rykovv/folding-flash-adc-pspice/adc_flash_4b_interp_fold/ADC_FLASH_4B_INTERP_FOLD.png

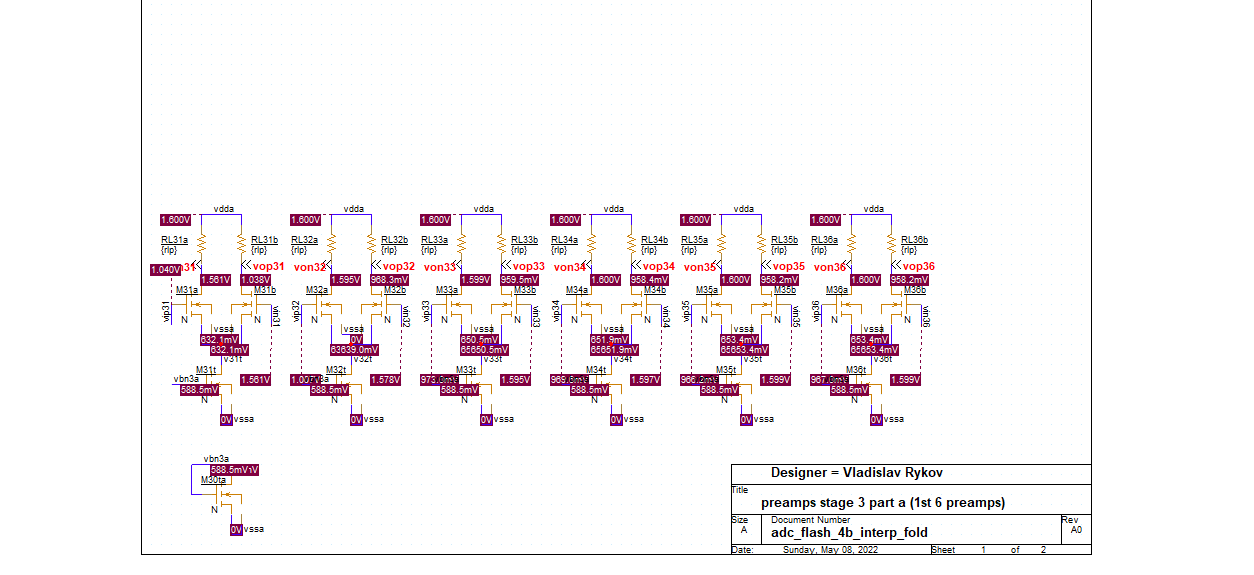
adc_flash_4b_interp_fold/ADC_FLASH_4B_INTERP_FOLD.png
