rykovv/folding-flash-adc-pspice/adc_flash_4b_interp_fold/adc_flash_4b_interp_fold.pdf

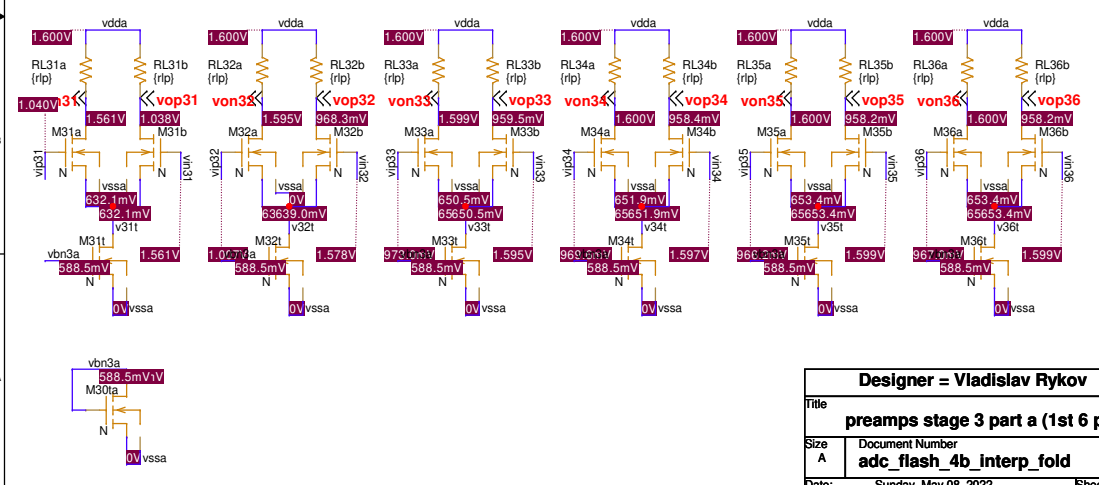
[picture p3: page 1]
von31; vop31 von32; vop32 von33; vop33 von34; vop34 von35; vop35 von36; vop36; Size; Document Number; Rev; Date:; Sheet; adc_flash_4b_interp_fold; 2Sunday, May 08, 2022; RL35a {rlp}; RL35b {rlp}; RL33a {rlp}; RL31b {rlp}; RL36a {rlp}; RL34a {rlp}; RL33b {rlp}; RL32a {rlp}; RL31a {rlp}; RL34b {rlp}; RL32b {rlp}; RL36b {rlp}; vdda; vssa 632.1mV 0V 632.1mV v31t; vip31; vin31; vssa 0V 63639 9.0mV.0mV; vssa 650.5mV 0V 650.5mV; vssa 651.9mV 0V 651.9mV; vssa 653.4mV 0V 653.4mV; vip32; vin32; vip33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

Designer = Vladislav Rykov

Title
preamps stage 3 part a (1st 6 preamps)

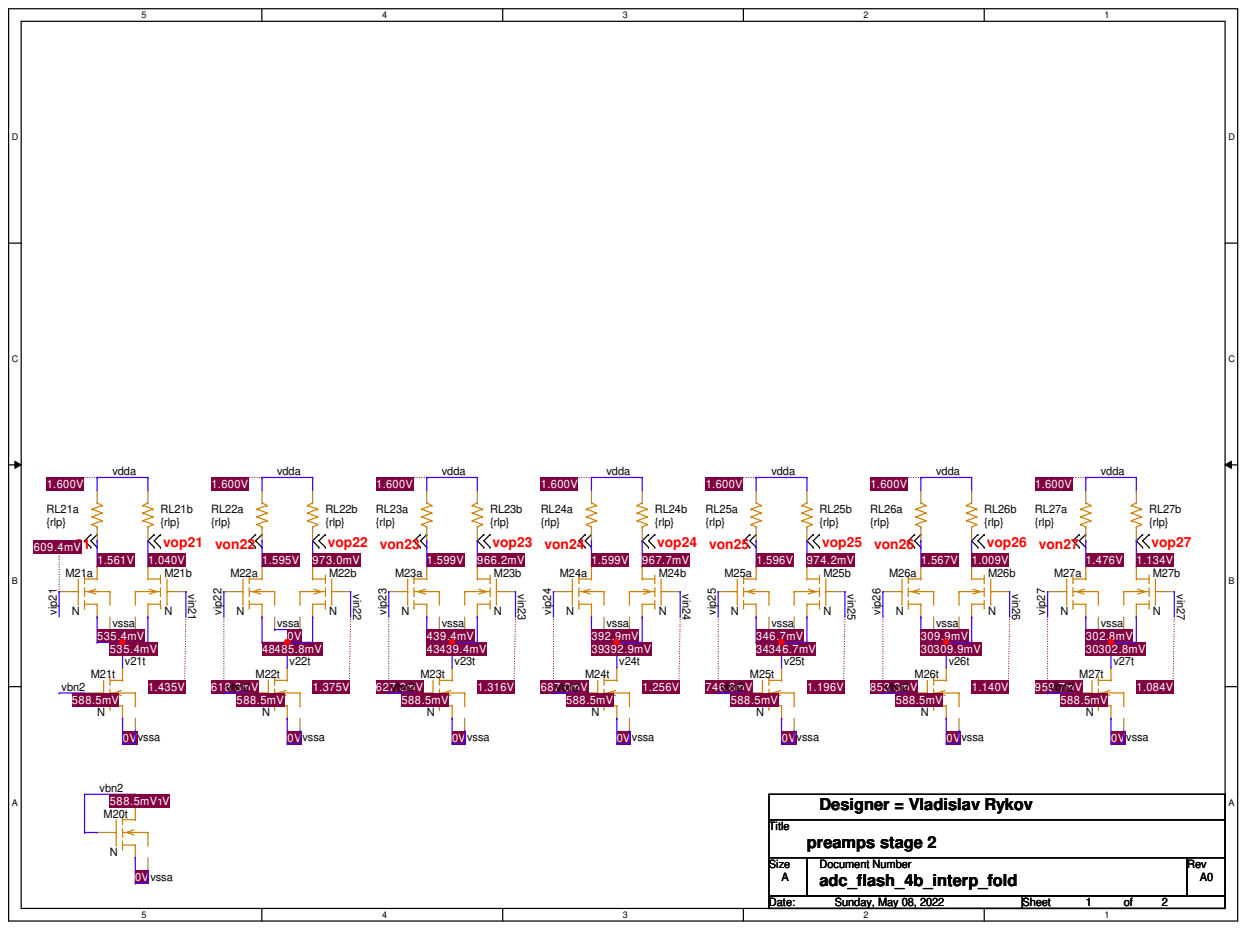
[picture p4: page 2]
von21; vop21 von22; vop22 von23; vop23 von24; vop24 von25; vop25 von26; vop26 von27; vop27; Title; Size; Document Number; Rev; adc_flash_4b_interp_fold; preamps stage 2; RL27b {rlp}; RL24a {rlp}; RL23b {rlp}; RL26a {rlp}; RL25b {rlp}; RL22a {rlp}; RL25a {rlp}; RL27a {rlp}; RL26b {rlp}; RL21a {rlp}; RL23a {rlp}; RL24b {rlp}; RL21b {rlp}; RL22b {rlp}; vdda; vssa 535.4mV 0V 535.4mV v21t; vip21; vin21; vssa 0V 48485 5.8mV.8mV; vssa 439.4mV 0V 439.4mV; vssa 392.9mV 0V 392.9mV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

Designer = Vladislav Rykov

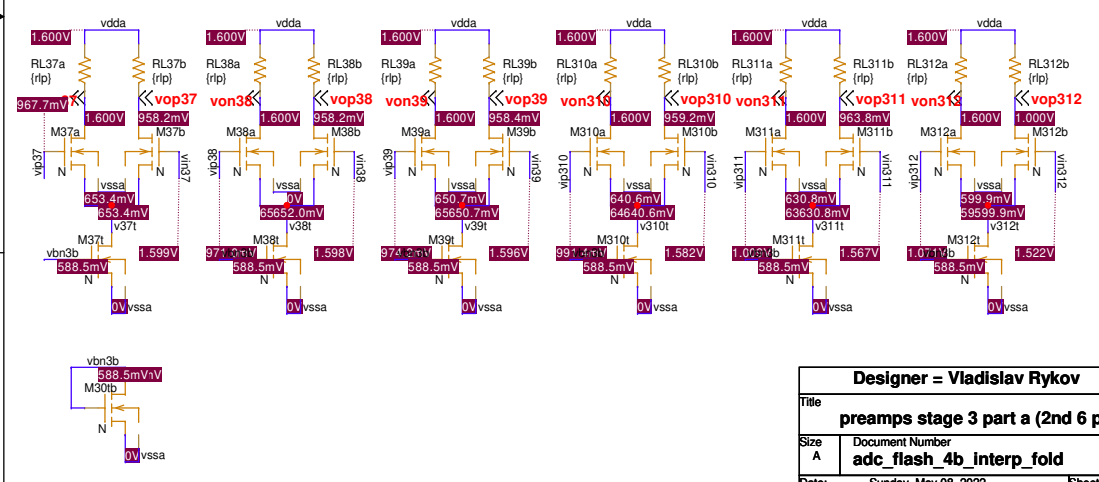
[picture p5: page 3]
von37; vop37 von38; vop38 von39; vop39 von310; vop310 von311; vop311 von312; vop312; Size; Document Number; Rev; adc_flash_4b_interp_fold; RL38a {rlp}; RL38b {rlp}; RL312b {rlp}; RL39b {rlp}; RL37a {rlp}; RL311b {rlp}; RL310a {rlp}; RL310b {rlp}; RL37b {rlp}; RL311a {rlp}; RL39a {rlp}; RL312a {rlp}; vdda; vssa 653.4mV 0V 653.4mV v37t; vip37; vin37; vssa 0V 65652 2.0mV.0mV; vssa 650.7mV 0V 650.7mV; vssa 640.6mV 0V 640.6mV; vssa 630.8mV 0V 630.8mV; vip38; vin38; vip39; vin39; vip310; vin310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

Designer = Vladislav Rykov

Title
preamps stage 3 part a (2nd 6 preamps)

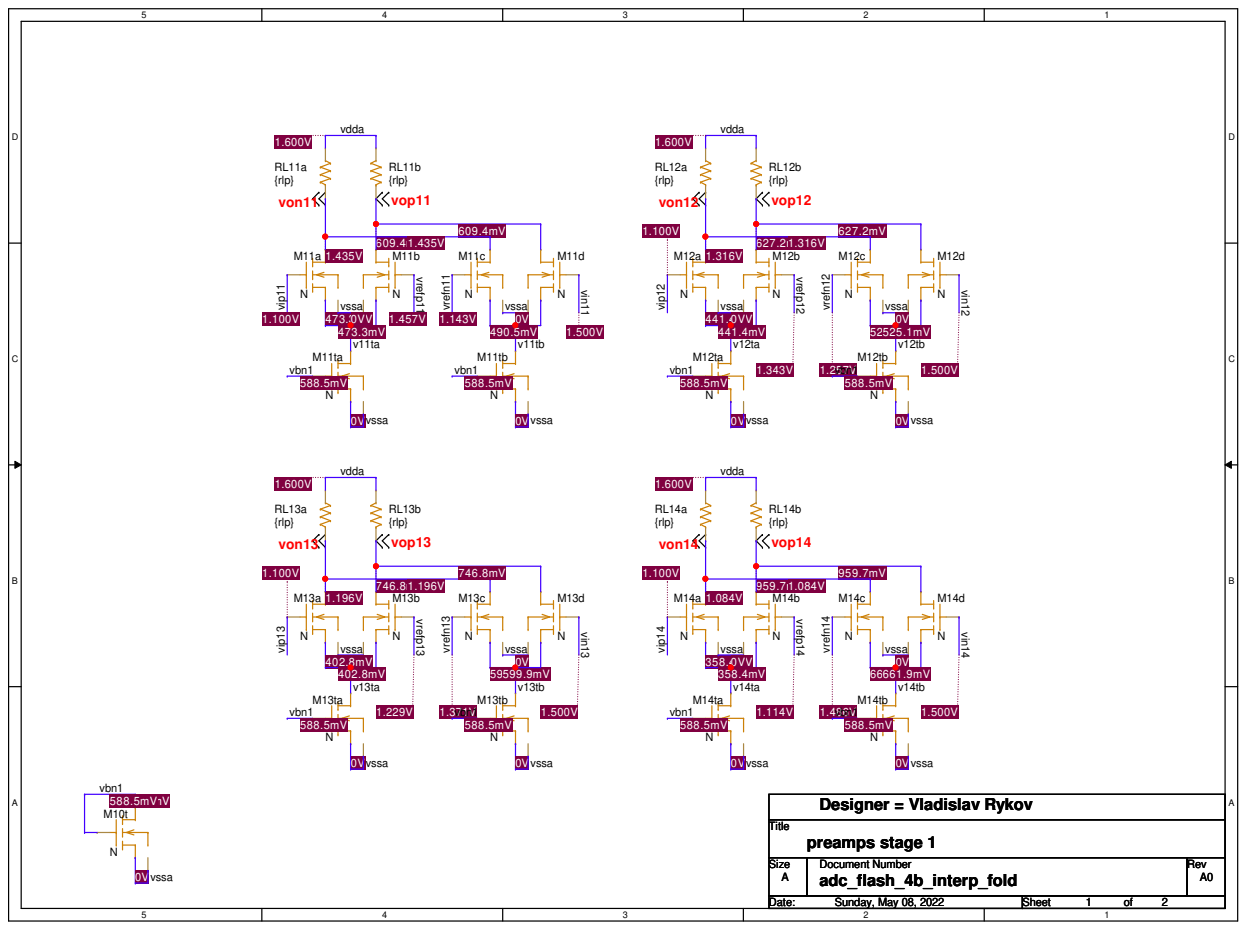
[picture p6: page 4]
von13; vop13; von11; vop11; von12; vop12; von14; vop14; Title; Size; Document Number; Rev; adc_flash_4b_interp_fold; preamps stage 1; RL11a {rlp}; RL13a {rlp}; RL11b {rlp}; RL12a {rlp}; RL12b {rlp}; RL14a {rlp}; RL13b {rlp}; RL14b {rlp}; vdda; vssa 402.8mV 0V 402.8mV v13ta; vip13; vrefp13; vssa 0V 599599.9mV.9mV; vrefn13; vin13; 0Vvssa; vbn1 588.5mV; vip11; vrefp11; vrefn11; vin11; vssa 0V; vip12; vrefp12; vrefn12; vin12; vip14; vrefp14; vrefn14; vin14

Designer = Vladislav Rykov

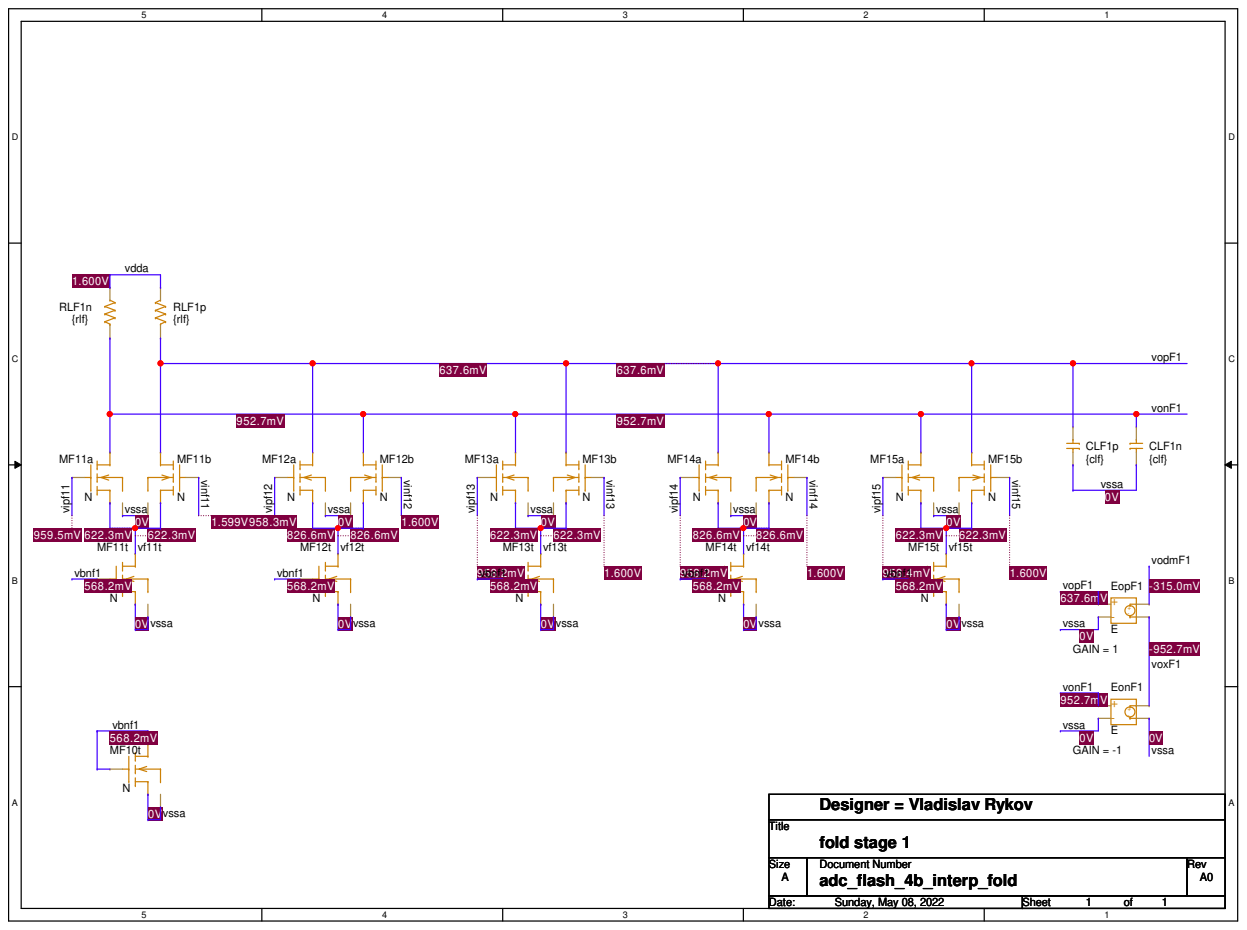
[picture p7: page 5]
Title; Size; Document Number; Rev; adc_flash_4b_interp_fold; fold stage 1; 1Sunday, May 08, 2022; CLF1n; {clf}; RLF1n {rlf}; -+ +-EopF1; GAIN = 1; RLF1p {rlf}; -+ +-EonF1; GAIN = -1; CLF1p; vdda; vopF1; vonF1; vipf11; vinf11; vipf12; vinf12; vipf13; vinf13; vipf14; vinf14; vipf15; vinf15; vssa 0V; vodmF1; voxF1 -952.7mV; vonF1 952.7mV; vssa; vbnf1 568.2mV; 0Vvssa

Designer = Vladislav Rykov

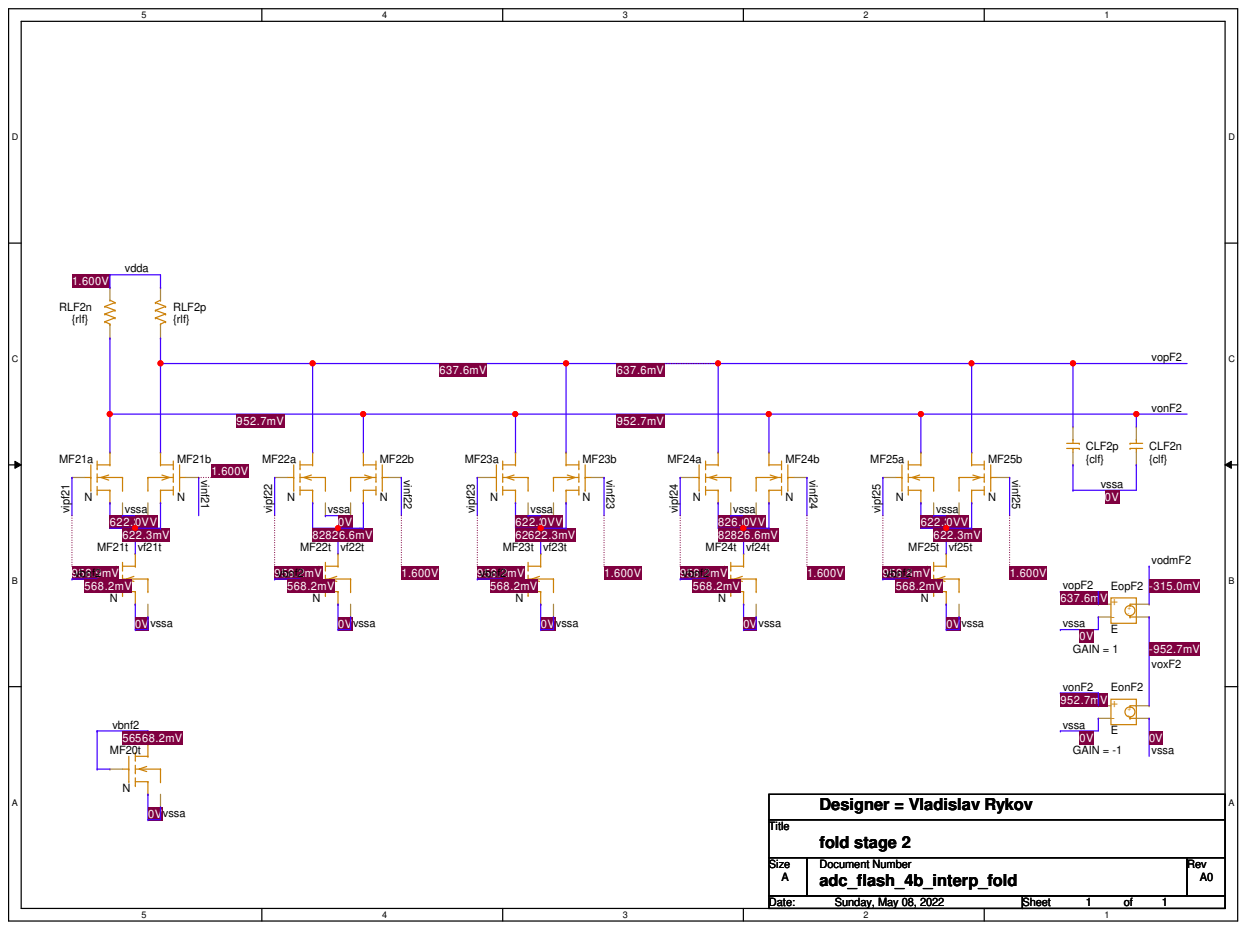
[picture p8: page 6]
Title; Size; Document Number; Rev; adc_flash_4b_interp_fold; fold stage 2; CLF2p {clf}; RLF2p {rlf}; RLF2n {rlf}; CLF2n {clf} -+ +-EonF2; GAIN = -1; -+ +-EopF2; GAIN = 1; vdda; vopF2; vonF2; vipf21; vinf21; vipf22; vinf22; vipf23; vinf23; vipf24; vinf24; vipf25; vinf25; vssa 0V; vodmF2; voxF2 -952.7mV; vonF2 952.7mV; vssa; vbnf2 568.2mV; 0Vvssa; vbnf2 56856.2mV 8.2mV

Designer = Vladislav Rykov

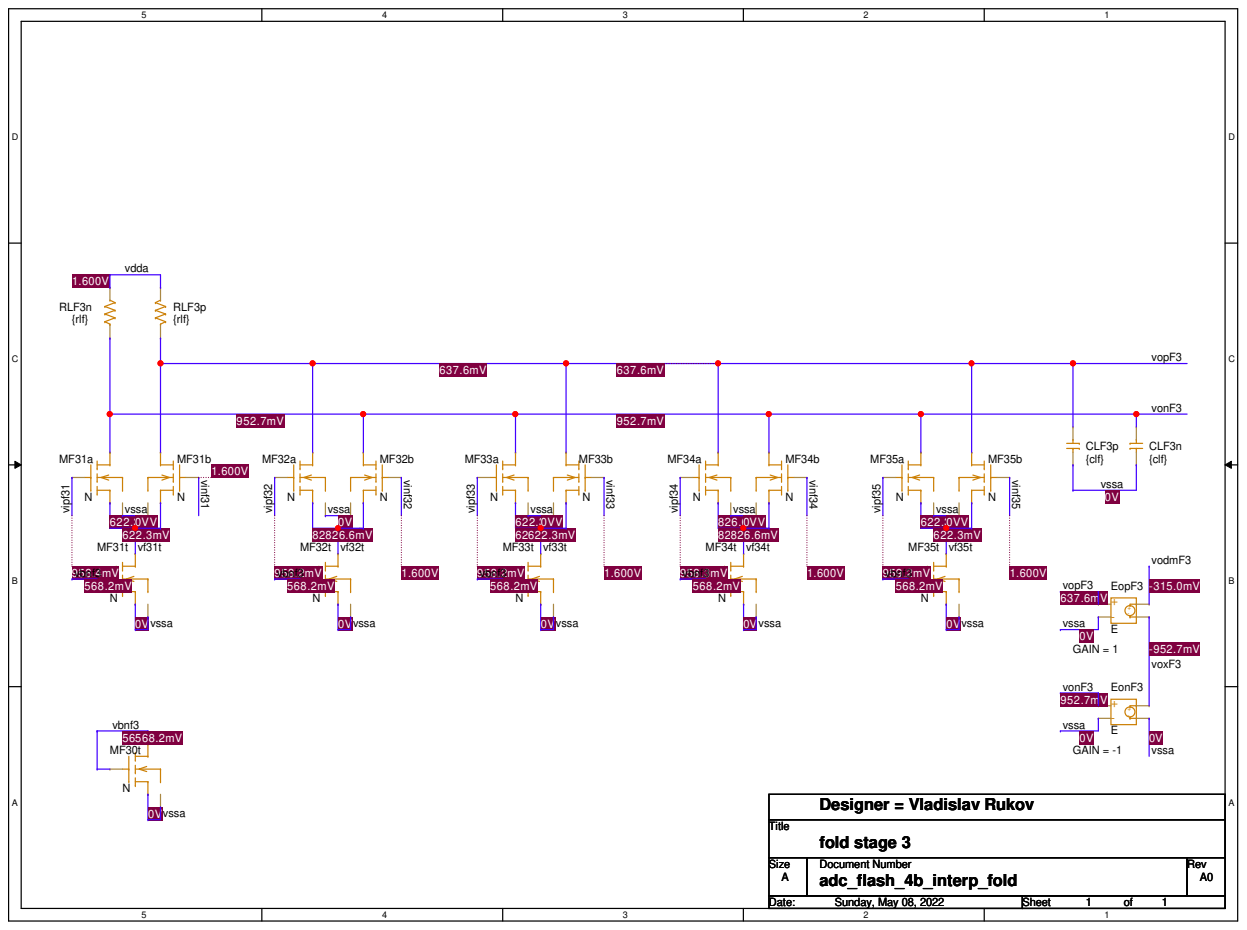
[picture p9: page 7]
Title; Size; Document Number; Rev; adc_flash_4b_interp_fold; fold stage 3; RLF3n {rlf}; CLF3n {clf} -+ +-EonF3; GAIN = -1; -+ +-EopF3; GAIN = 1; CLF3p {clf}; RLF3p {rlf}; vdda; vopF3; vonF3; vipf31; vinf31; vipf32; vinf32; vipf33; vinf33; vipf34; vinf34; vipf35; vinf35; vssa 0V; vodmF3; voxF3 -952.7mV; vonF3 952.7mV; vssa; vbnf3 568.2mV; 0Vvssa; vbnf3 56856.2mV 8.2mV

Designer = Vladislav Rukov

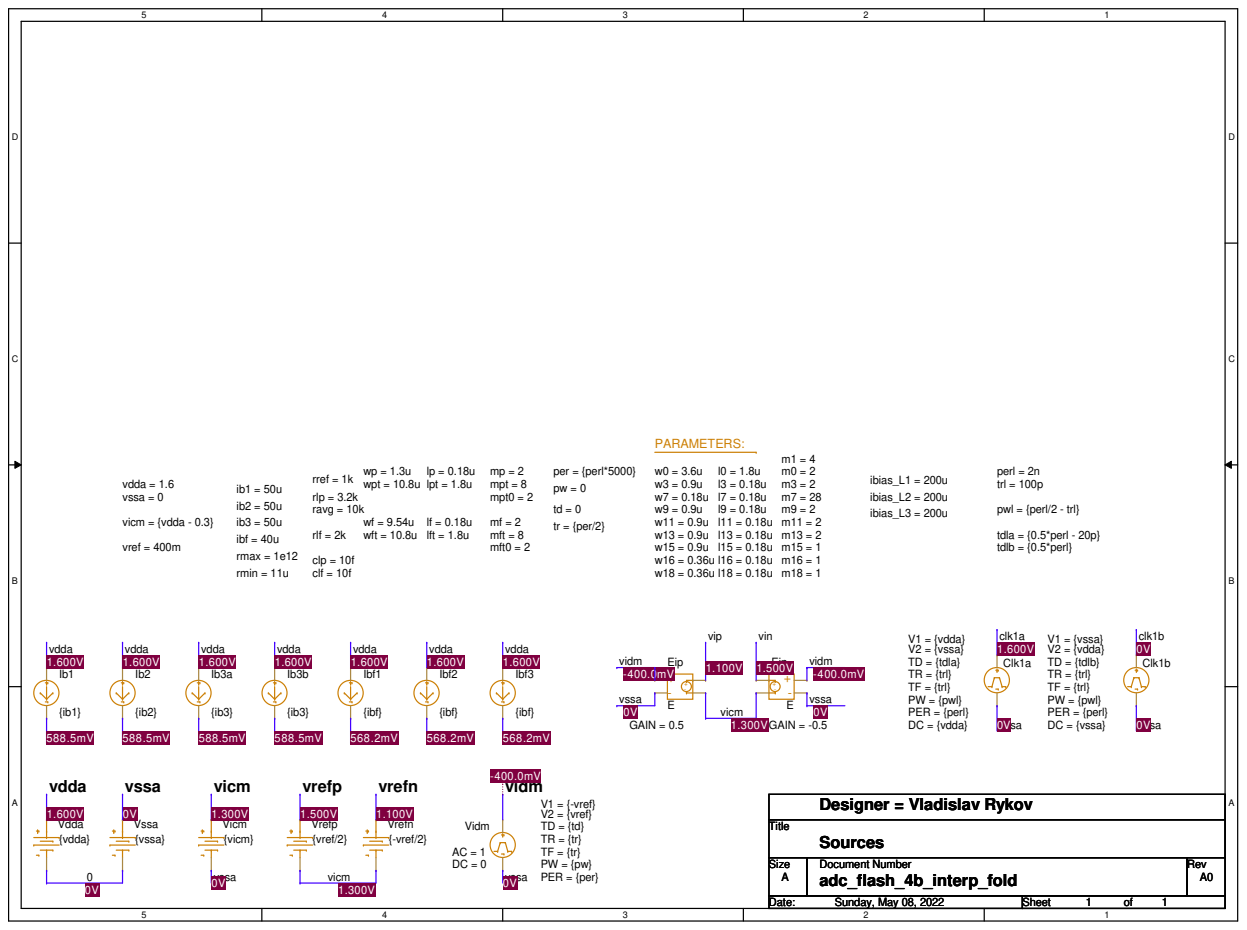
[picture p10: page 8]
Title; Size; Document Number; Rev; adc_flash_4b_interp_fold; Sources; TD = {tdlb}; Clk1b; TF = {trl} PW = {pwl} PER = {perl}; V1 = {vssa}; TR = {trl}; V2 = {vdda}; DC = {vssa}; Ibf3; {ibf}; Vicm {vicm}; Ibf2; Vrefp; {vref/2}; +-Eip; GAIN = 0.5; Vidm; TF = {tr} PW = {pw} PER = {per}; V1 = {-vref}; V2 = {vref}; Ibf1; TD = {tdla}; Clk1a; V1 = {vdda}; V2 = {vssa}; DC = {vdda}; Vrefn; {-vref/2}; +- Ein; GAIN = -0.5; PARAMETERS:; vdda = 1.6 vssa = 0; vref = 400m; vicm = {vdda - 0.3}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

pwl = {perl/2 - trl}

Designer = Vladislav Rykov

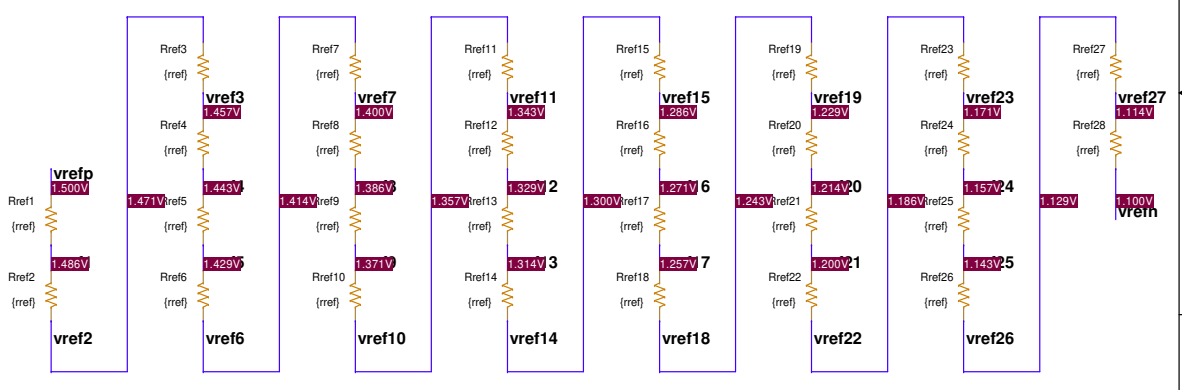
[picture p11: page 9]
Title; Size; Document Number; Rev; adc_flash_4b_interp_fold; Rref25; {rref}; Rref4; Rref12; Rref10; Rref17; Rref27; Rref22; Rref26; Rref5; Rref13; Rref18; Rref7; Rref28; Rref6; Rref14; Rref19; Rref23; Rref8; Rref15; Rref1; Rref20; Rref24; Rref3; Rref9; Rref11; Rref16; Rref2; Rref21; vref7; 1.386V vref8; 1.371V vref9; vref10; vref11; 1.329V vref12; 1.314V vref13; vref14; vref15; 1.271V vref16; 1.257V vref17; vref18; vref19; 1.214V vref20; 1.200V vref21; vref22; vref3; 1.443V vref4; 1.429V vref5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

Designer = Vladislav Rykov

ADC reference resistor ladder

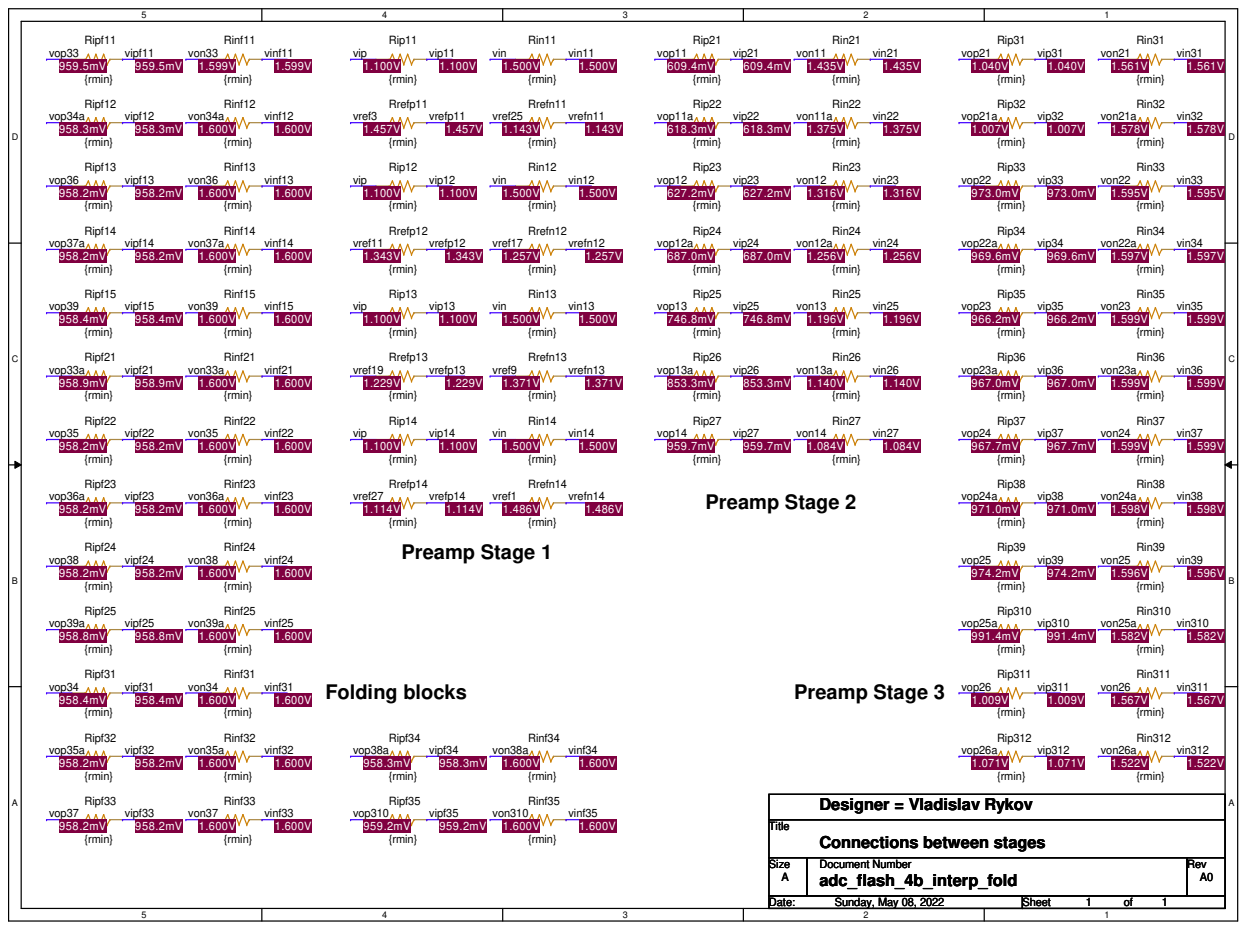
[picture p12: page 10]
Preamp Stage 1; Preamp Stage 2; Title; Size; Document Number; Rev; adc_flash_4b_interp_fold; Rip32; {rmin}; Rin24; Rin31; Rrefn14; Rin26; Rin35; Rrefn11; Rin39; Rip36; Ripf32; Ripf34; Rin12; Ripf21; Rip13; Rip38; Ripf23; Ripf12; Rip312; Ripf25; Rip31; Ripf13; Rinf32; Rinf34; Rin32; Rinf21; Rin13; Rip21; Rin36; Rinf23; Rinf12; Rin310; Rip23; Rinf25; Ripf14; Rip14; Rip25; Rip27; Rinf13; Rip39; Rin21; Rrefp12; Ripf15; Rin23; Rinf14; Rin14; Rin25; Ripf11; Rin33; Rip33; Rin27; Rin37; Rip34; Ripf31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

Preamp Stage 3Folding blocks

Designer = Vladislav Rykov

Connections between stages

# Preamp

# Analog Latch

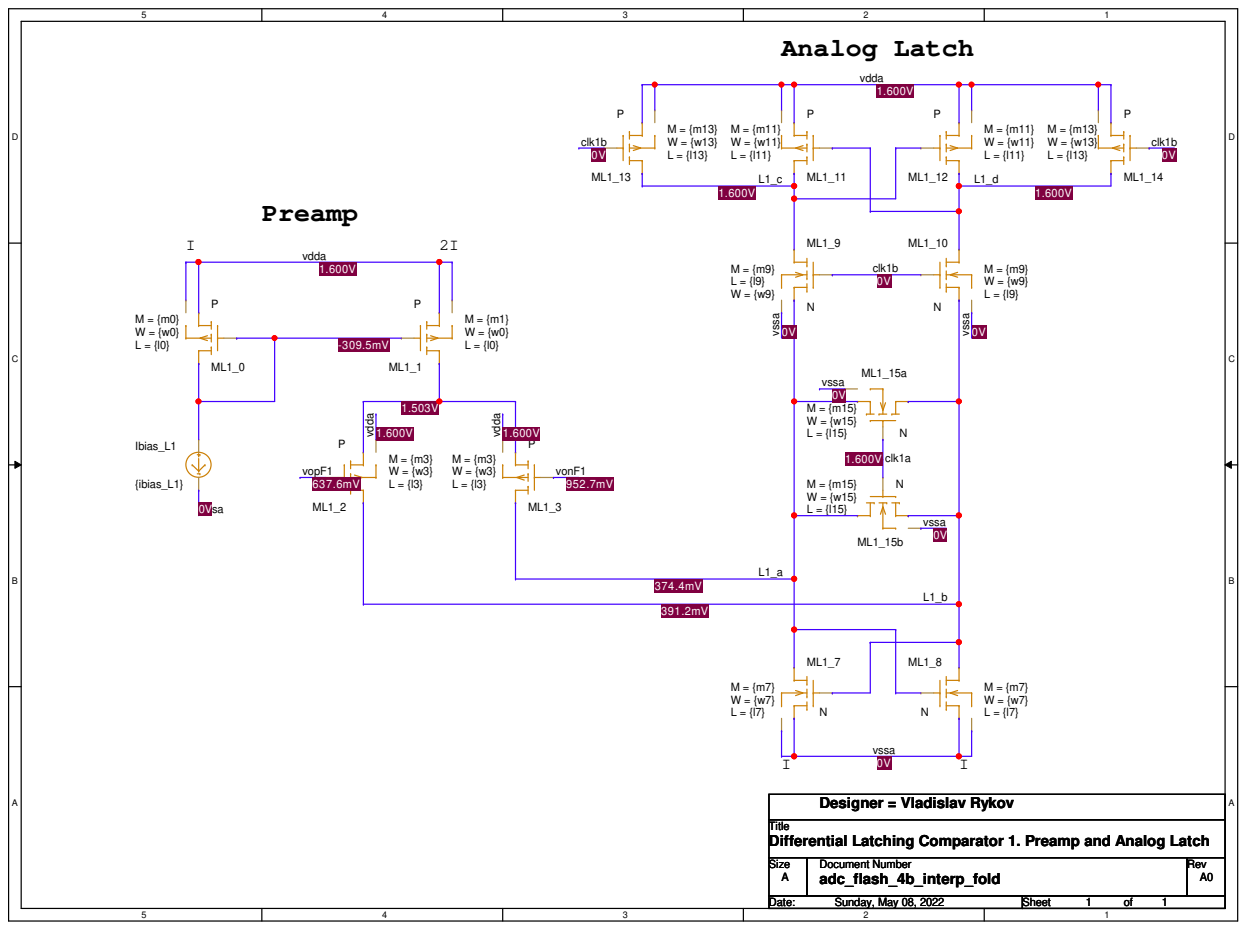
[picture p13: page 11]
Size; Document Number; Rev; adc_flash_4b_interp_fold; Ibias_L1; {ibias_L1}; vdda 1.600V; vopF1 637.6mV; vonF1 952.7mV; clk1a; vssa 0V; clk1b 0V; 0Vvssa; vssa 0V vssa 0V

Designer = Vladislav Rykov

Title
Differential Latching Comparator 1. Preamp and Analog Latch

# Digital S/R Latch

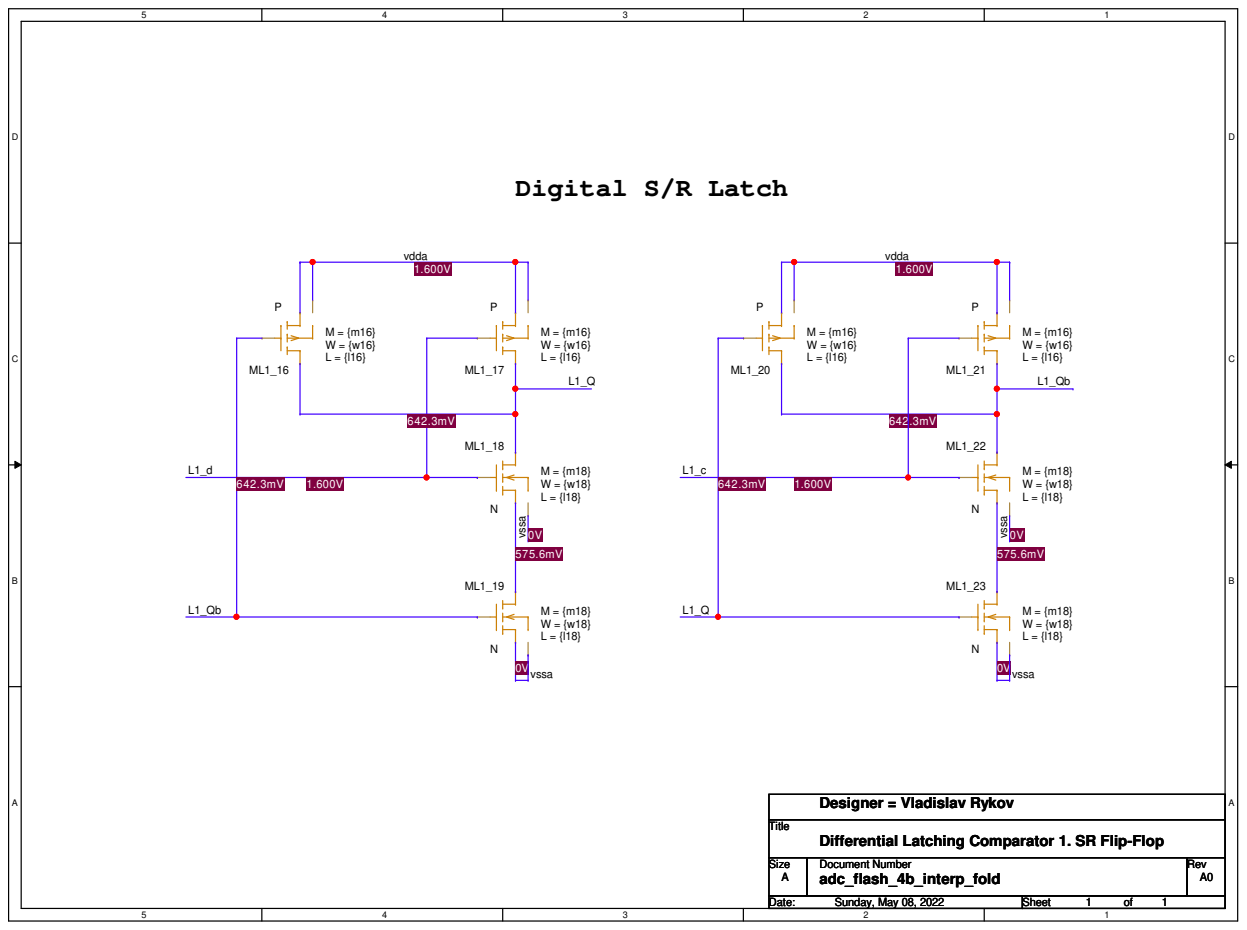
[picture p14: page 12]
Title; Size; Document Number; Rev; adc_flash_4b_interp_fold; vdda 1.600V; 0Vvssa; vssa 0V

Designer = Vladislav Rykov

Differential Latching Comparator 1. SR Flip-Flop

# Analog Latch

# Preamp

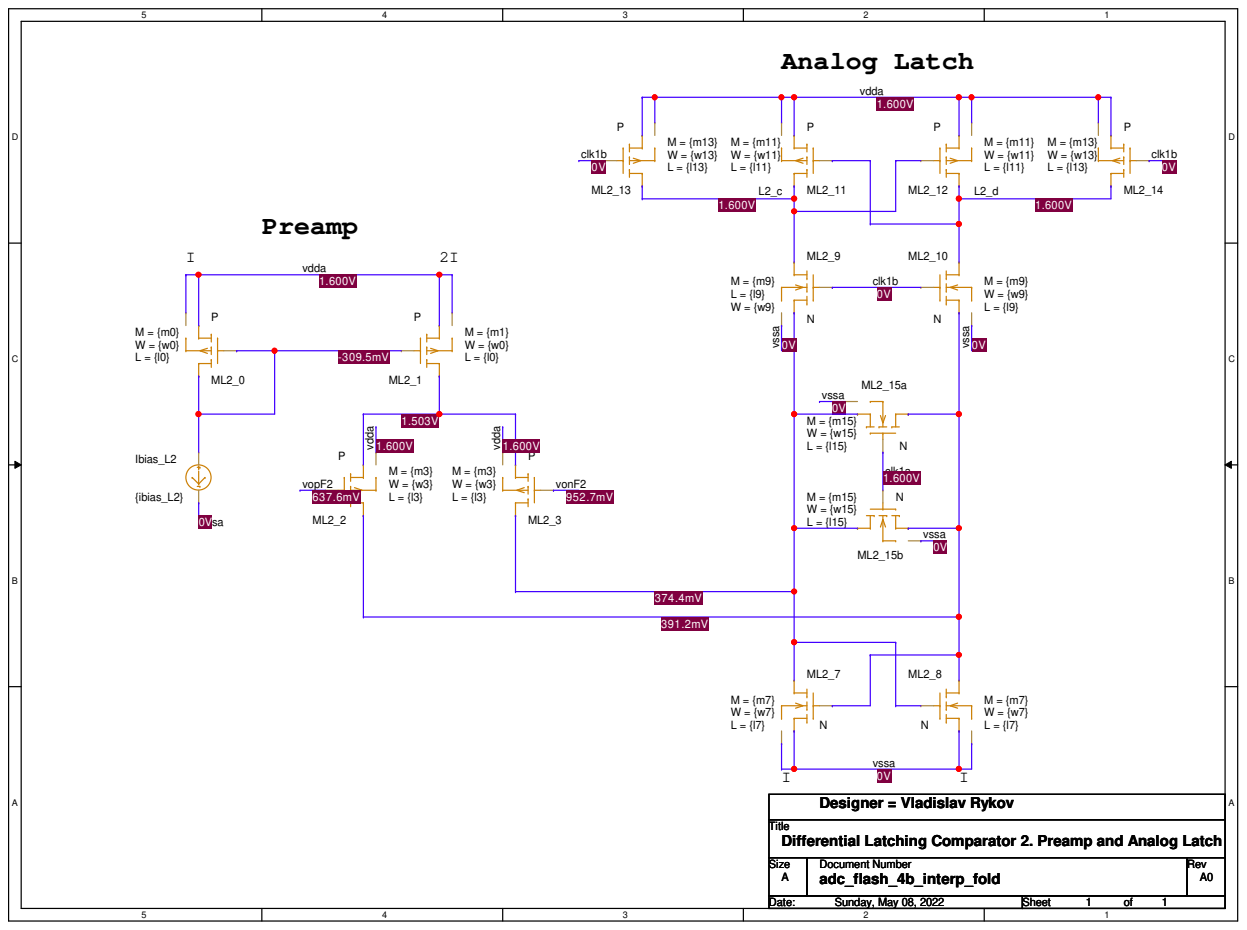
[picture p15: page 13]
Size; Document Number; Rev; adc_flash_4b_interp_fold; Ibias_L2; {ibias_L2}; vdda 1.600V; clk1b 0V; vdda; clk1b; vssa 0V vssa 0V; vssa 0V; 1.503V vdda 1.600V; clk1a 1.600V vopF2; vonF2 952.7mV; 0Vvssa

Designer = Vladislav Rykov

Title
Differential Latching Comparator 2. Preamp and Analog Latch

# Digital S/R Latch

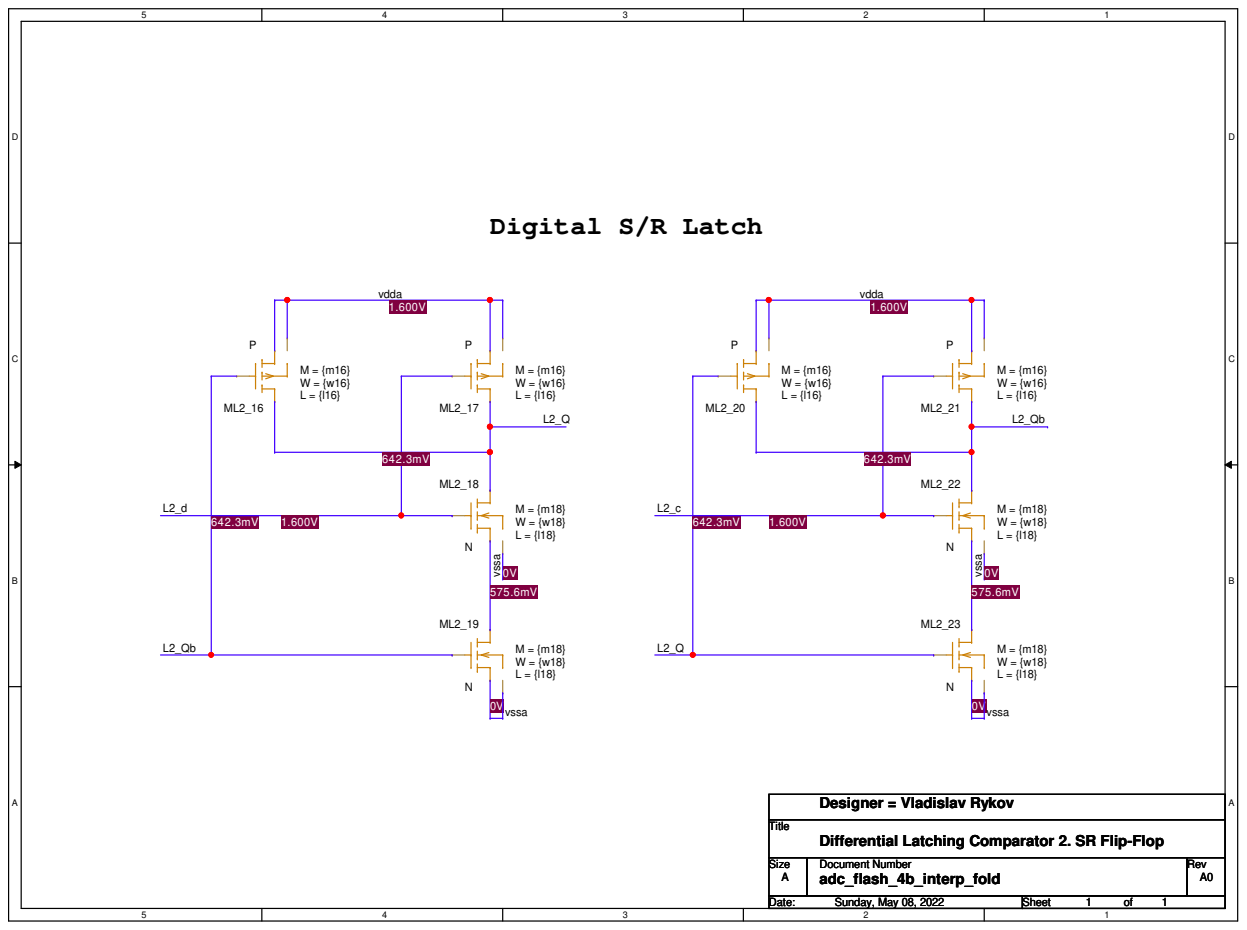
[picture p16: page 14]
Title; Size; Document Number; Rev; adc_flash_4b_interp_fold; vdda 1.600V; vssa 0V vssa 0V; 0V vssa; vssa

Designer = Vladislav Rykov

Differential Latching Comparator 2. SR Flip-Flop

# Analog Latch

# Preamp

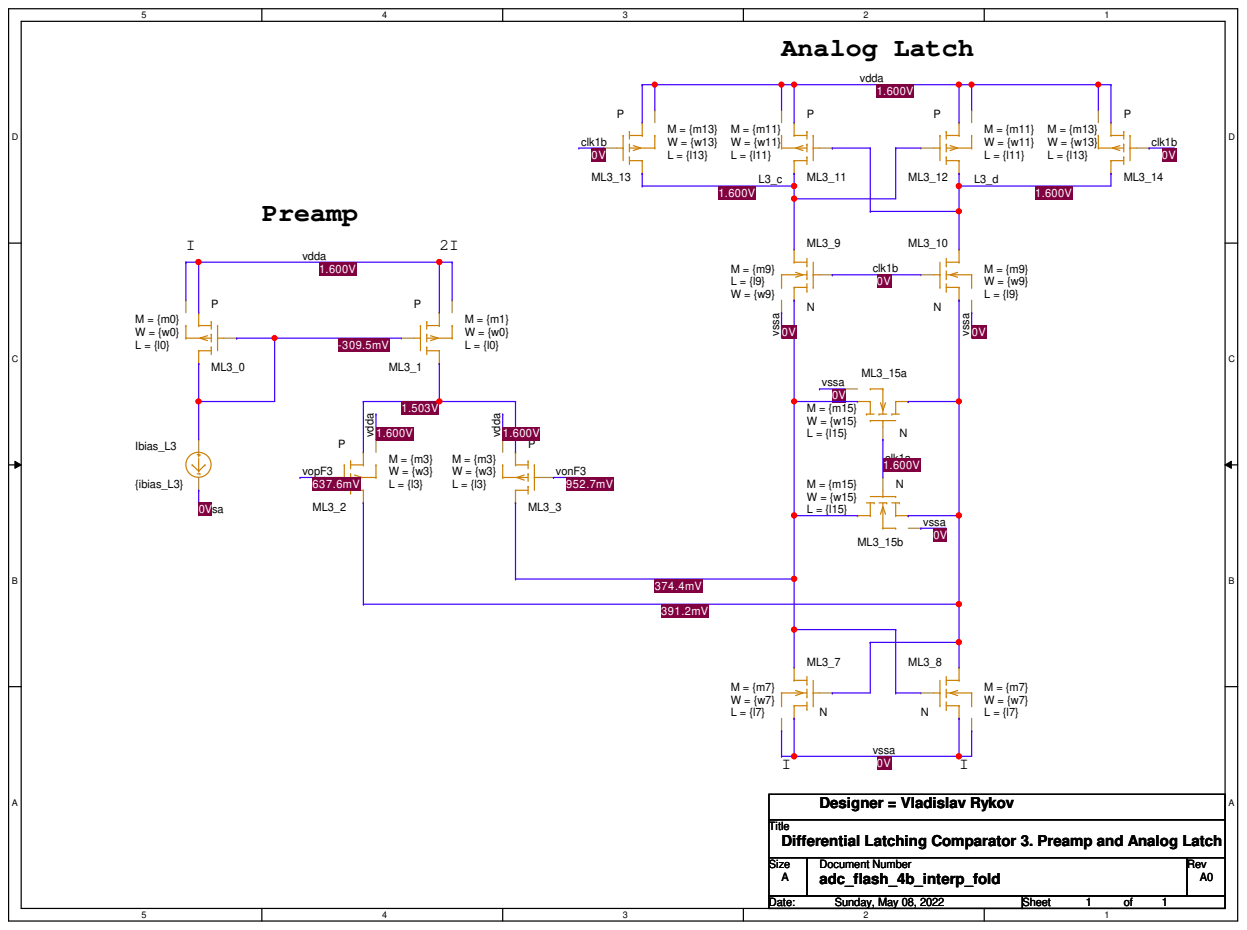
[picture p17: page 15]
Size; Document Number; Rev; adc_flash_4b_interp_fold; Ibias_L3; {ibias_L3}; vdda 1.600V; clk1b 0V; vdda; clk1b; vssa 0V vssa 0V; vssa 0V; 1.503V vdda 1.600V; clk1a 1.600V vopF3; vonF3 952.7mV; 0Vvssa

Designer = Vladislav Rykov

Title
Differential Latching Comparator 3. Preamp and Analog Latch

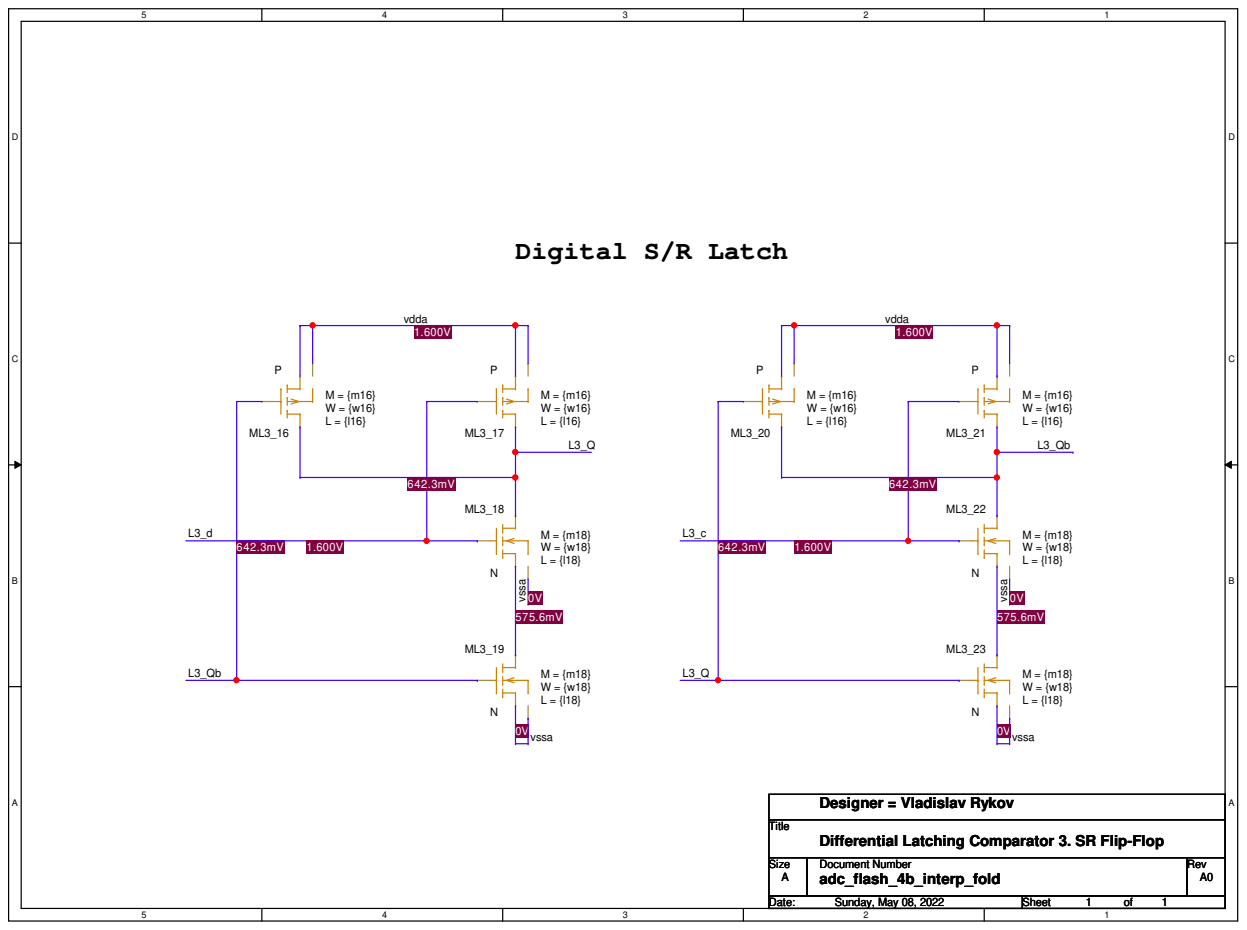
[picture p18: page 16]
Digital S/R Latch; Title; Size; Document Number; Rev; adc_flash_4b_interp_fold; vdda 1.600V; vssa 0V vssa 0V; 0V vssa; vssa

Designer = Vladislav Rykov

Differential Latching Comparator 3. SR Flip-Flop

## vol3

## vdda

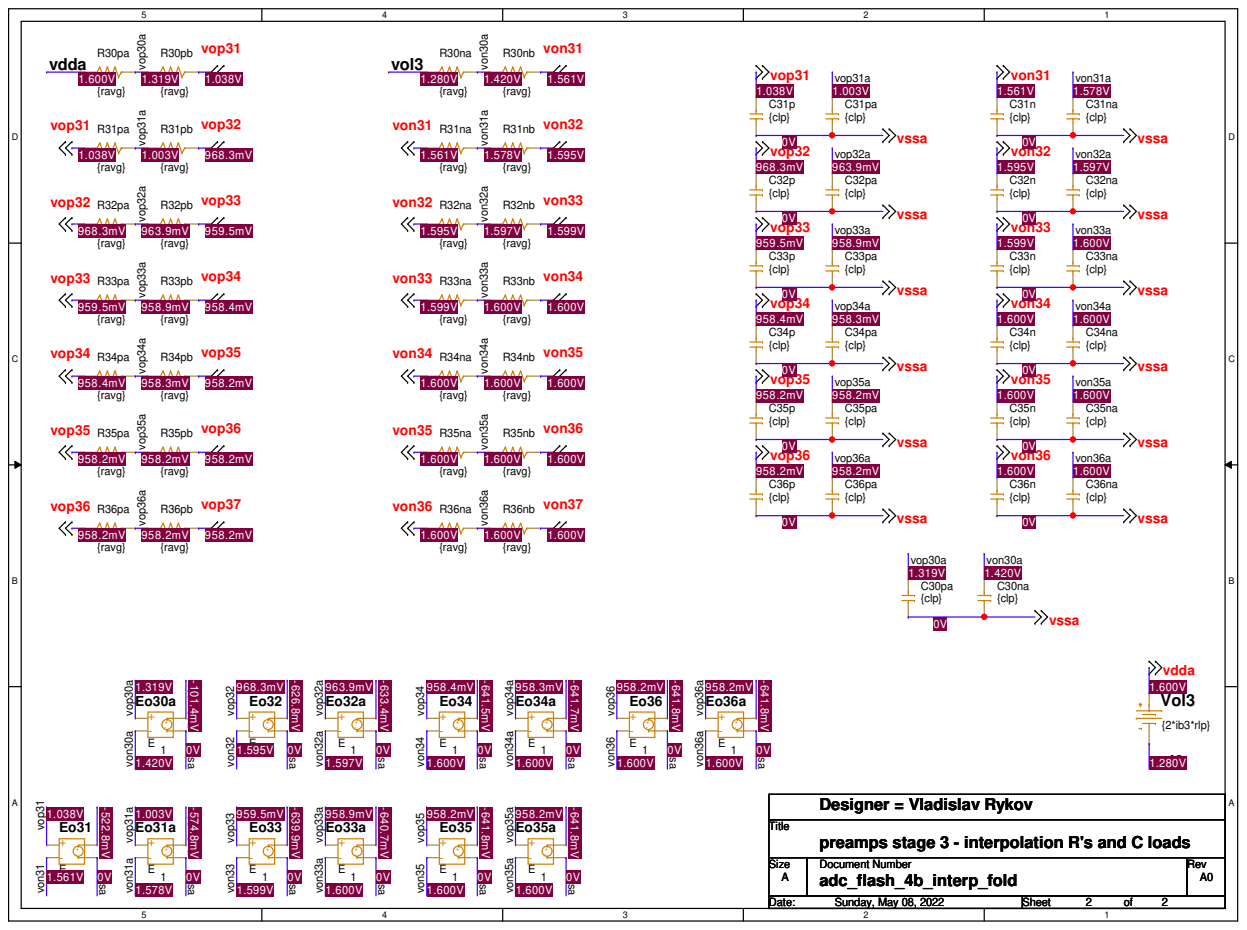
[picture p19: page 17]
vop31; vop32; vop33; vop34; vop35; vop36; vop37; von34; von35; von36; von37; von31; von32; von33; vssa; vdda; Title; Size; Document Number; Rev; adc_flash_4b_interp_fold; {ravg}; C30pa {clp}; C33na {clp}; C32n {clp}; C34na {clp}; C31na {clp}; C35p {clp}; C35n {clp}; C30na {clp}; C34p {clp}; C31pa {clp}; C36n {clp}; C32na {clp}; C35pa {clp}; C35na {clp}; Vol3; {2*ib3*rlp}; C34pa {clp}; C36p {clp}; C31p {clp}; C36na {clp}; C36pa {clp}; C33p {clp}; C32p {clp}; C33n {clp}; C31n {clp}; C33pa {clp}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

Designer = Vladislav Rykov

preamps stage 3 - interpolation R's and C loads

## vol2

## vdda

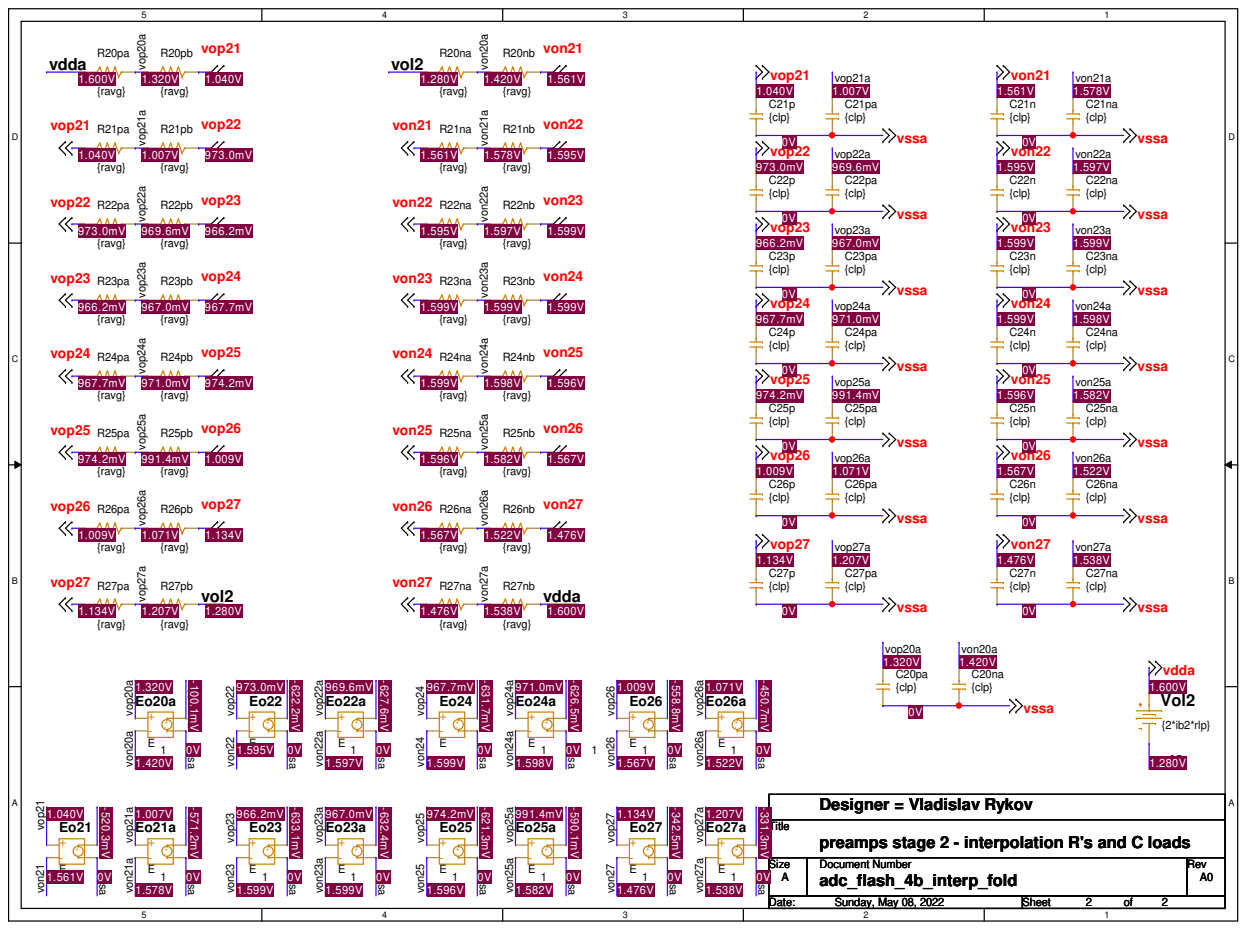
[picture p20: page 18]
vop21; vop22; vop23; vop24; vop25; vop26; vop27; von24; von25; von26; von27; von21; von22; von23; vssa; vdda; Title; Size; Document Number; Rev; adc_flash_4b_interp_fold; C25p {clp}; {ravg}; C21p {clp}; C26na {clp}; C23p {clp}; C23n {clp}; C23pa {clp}; C20pa {clp}; C24p {clp}; Vol2; {2*ib2*rlp}; C23na {clp}; C25n {clp}; C22n {clp}; C20na {clp}; C26p {clp}; C24na {clp}; C27p {clp}; C22p {clp}; C25pa {clp}; C27pa {clp}; C21n {clp}; C22pa {clp}; C21na {clp}; {clp}; C25na {clp}; C26n {clp}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

Designer = Vladislav Rykov

preamps stage 2 - interpolation R's and C loads

# {ravg} -+ +- Eo37a

# {clp} -+ +- Eo311a

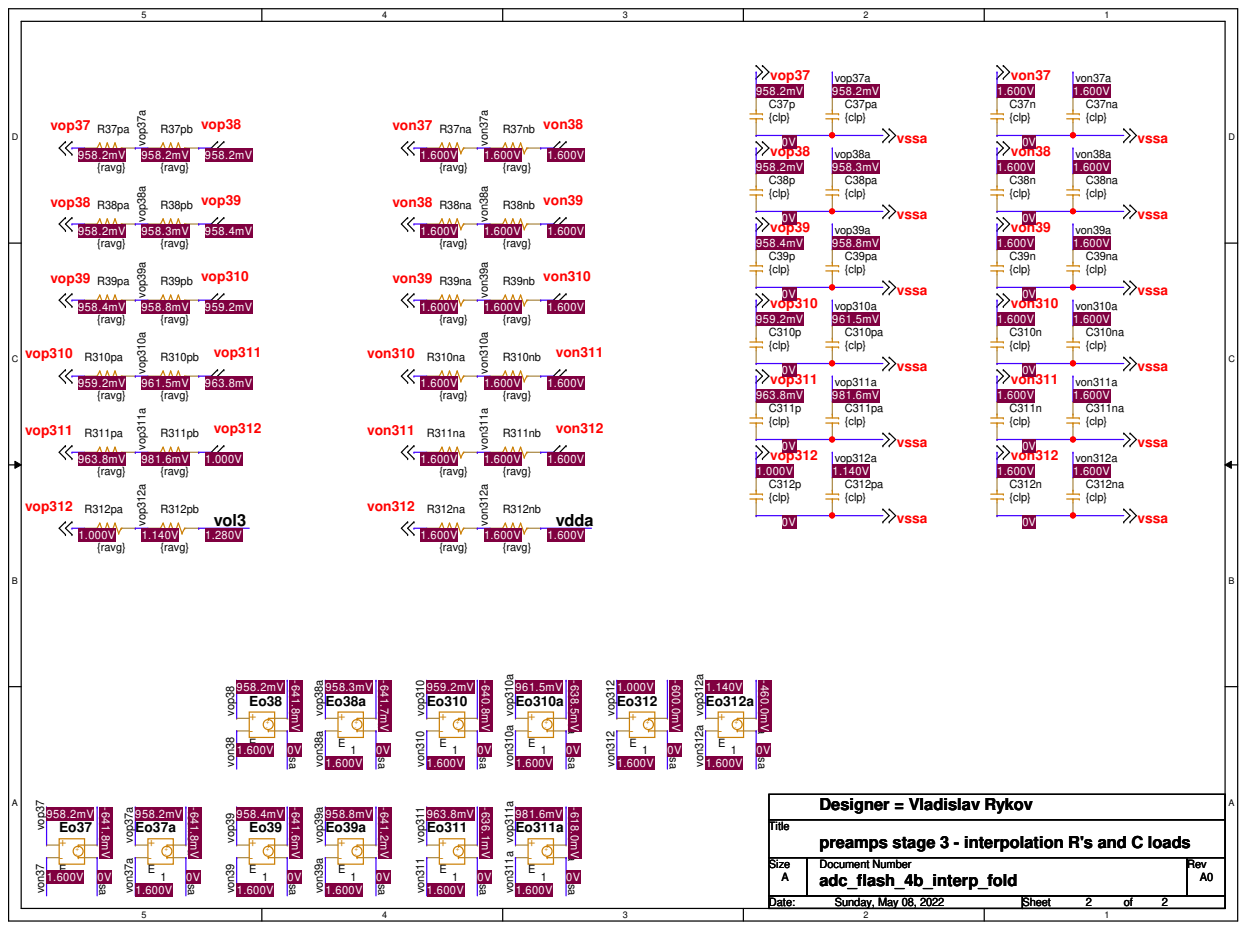
[picture p21: page 19]
vop37; vop38; vop39; vop310; vop311; vop312; von310; von311; von312; von37; von38; von39; vssa; Title; Size; Document Number; Rev; adc_flash_4b_interp_fold; {ravg}; C38na {clp}; C37p {clp}; C312na {clp}; C310p {clp}; C39pa {clp}; C39na {clp} -+ +- Eo39a; C310na {clp} -+ +-Eo38; C311pa {clp}; C38n {clp} -+ +- Eo311; C37pa {clp}; C37na {clp}; C39n {clp}; C311n {clp}; C310pa {clp}; C39p {clp}; C37n {clp}; C310n {clp} -+ +- Eo310a; C312pa {clp} -+ +- Eo38a; C311na {clp} -+ +-Eo37; C311p {clp}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

Designer = Vladislav Rykov

preamps stage 3 - interpolation R's and C loads

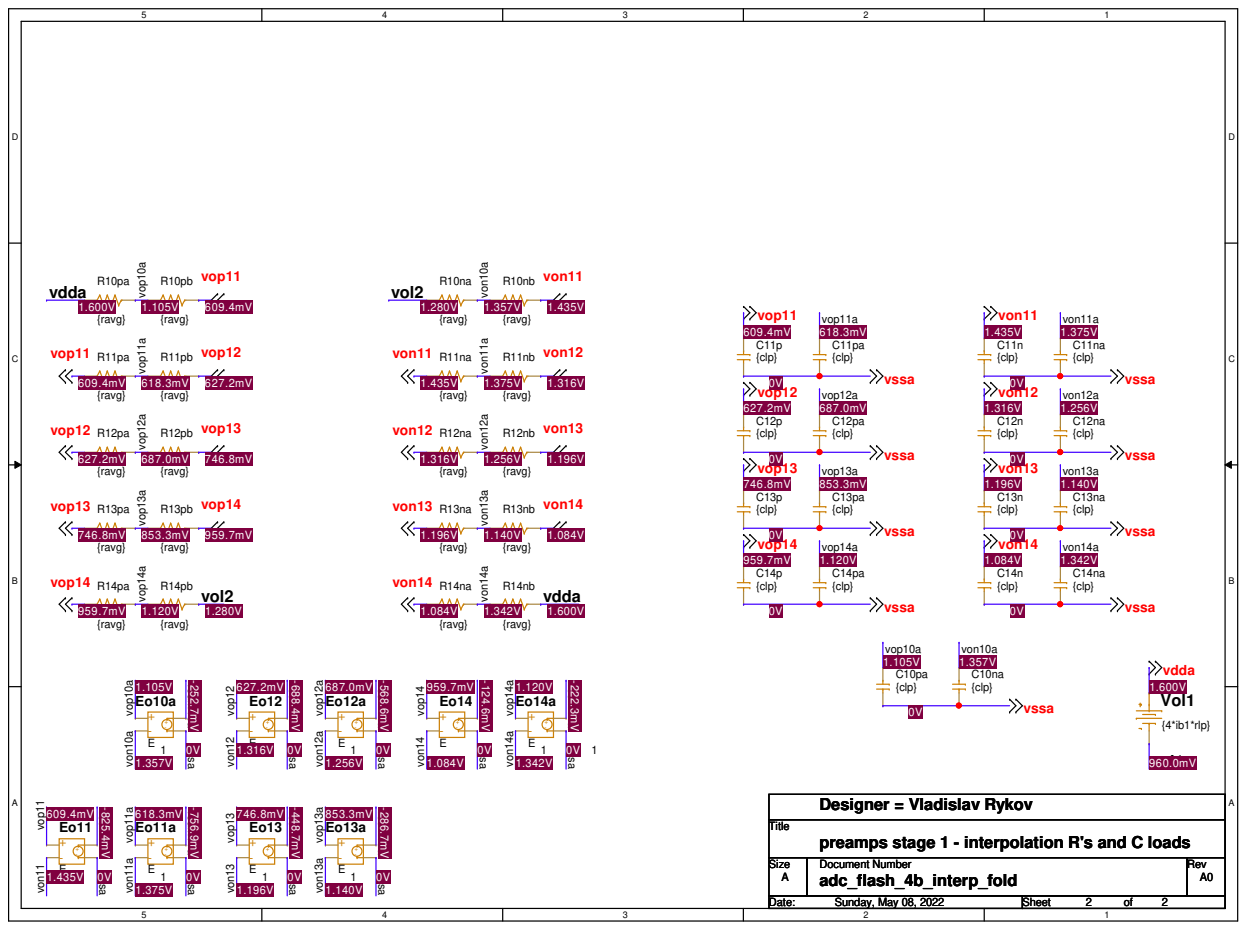
[picture p22: page 20]
vop11; vop12; vop13; vop14; von11; von12; von13; von14; vssa; vdda; Title; Size; Document Number; Rev; adc_flash_4b_interp_fold; {ravg}; C12pa {clp}; C14pa {clp}; C11na {clp}; C10na {clp}; C14n {clp}; C14p {clp}; C11p {clp} -+ +-Eo13; C13na {clp}; C13p {clp} -+ +- Eo12a; C12na {clp}; C13n {clp}; R12pb {ravg} -+ +- Eo11a; C14na {clp} -+ +-Eo14; C12n {clp}; Vol1; {4*ib1*rlp}; C11n {clp}; {clp}; C11pa {clp}; R10pa {ravg} -+ +-Eo11; C12p {clp} -+ +- Eo14a; {ravg} -+ +-Eo12; C10pa {clp}; vop11a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

Designer = Vladislav Rykov -+ +- Eo13a

Designer = Vladislav Rykov

preamps stage 1 - interpolation R's and C loads
