rykovv/folding-flash-adc-pspice/(list of files, drawings)

Other design files:
adc_flash_4b_interp_fold/adc_flash_4b_interp_fold.dsn
adc_flash_4b_interp_fold/adc_flash_4b_interp_fold.opj
